tceoo1/TubeTester/doc/真空管特性計測基板.pdf

# 真空管特性計測基板 TubeTester

# これは何？

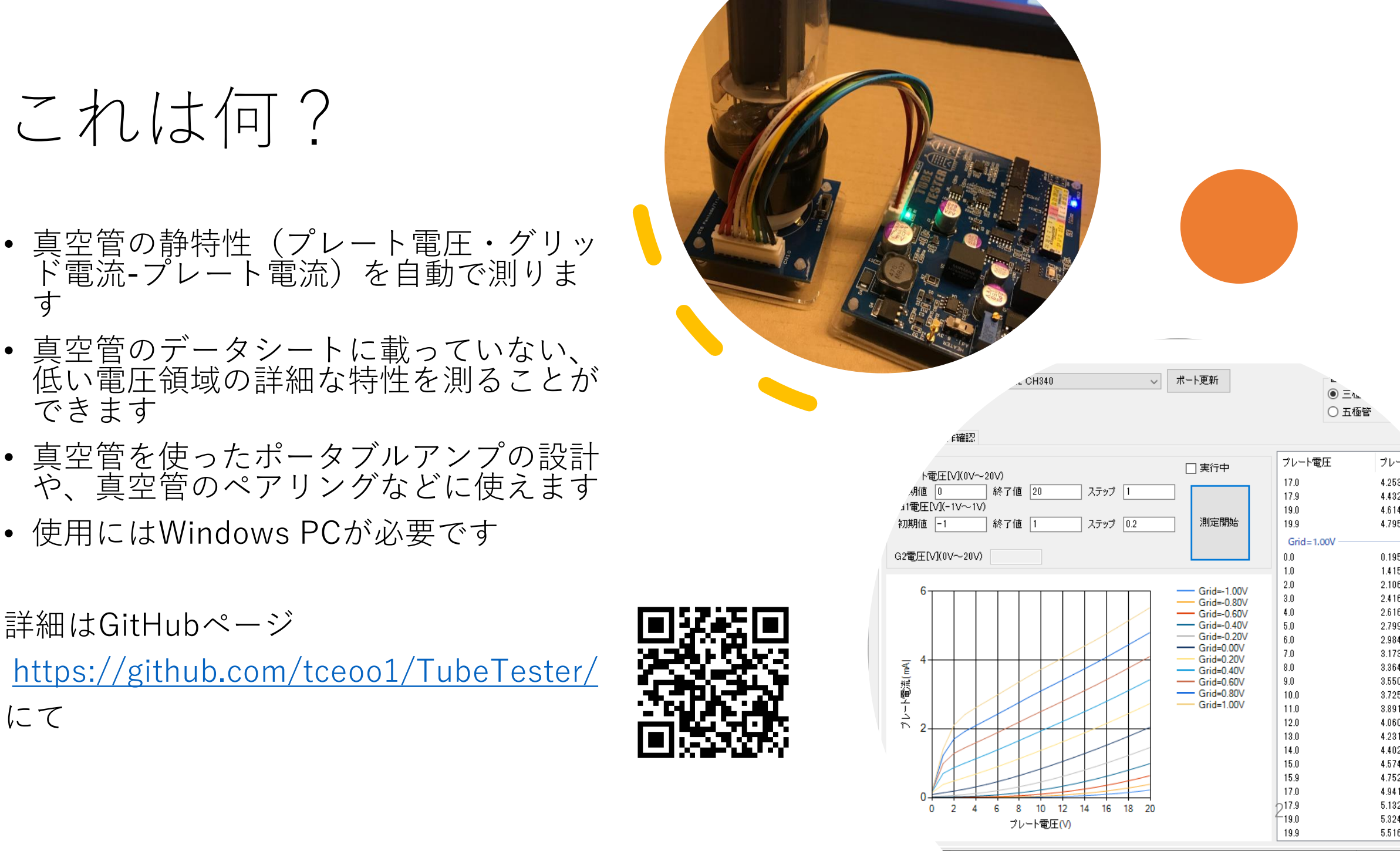
[picture p3: page 2]

- 真空管の静特性（プレート電圧・グリッ
ド電流

-プレート電流）を自動で測りま
す
- 真空管のデータシートに載っていない、
低い電圧領域の詳細な特性を測ることが
できます
- 真空管を使ったポータブルアンプの設計
や、真空管のペアリングなどに使えます
- 使用にはWindows PCが必要です

詳細はGitHubページ
https://github.com/tceoo1/TubeTester/にて

# 各部の説明

電圧チェック
端子（＋）

電圧チェック
端子（ー）

電圧調整VR

ヒータ電圧切
り替えSW

真空管電源

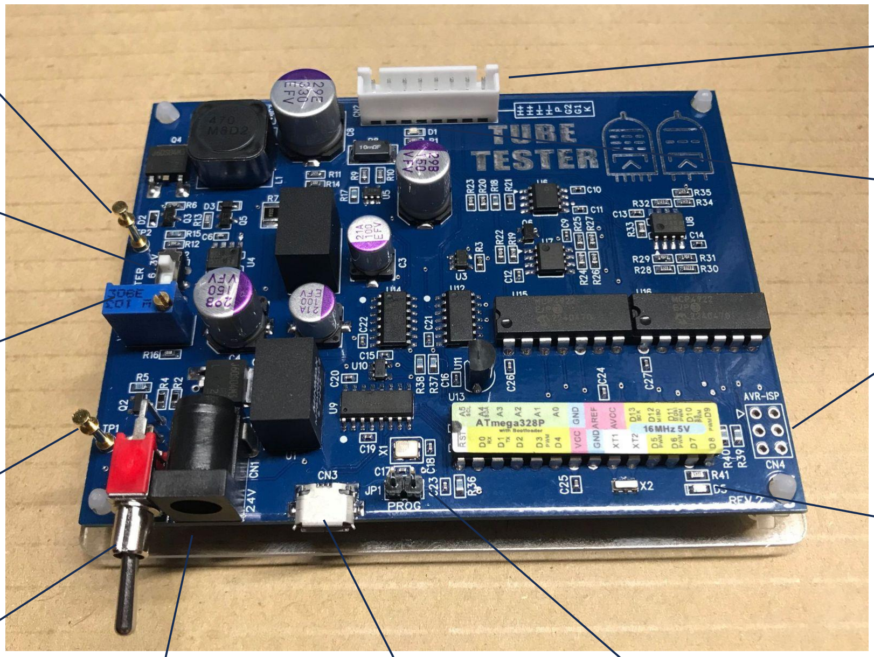
[picture p4: figure]

SW | 真空管電源
| (２４V)

PC接続
USB端子

真空管接続
端子

AVR ISP端子
（未実装）

スケッチ書き込
み用ジャンパ

真空管電源
LED（緑）

AVR動作
LED（青）

# 各部の説明

名称 | 説明
電圧チェック端子 | ヒータ電圧のチェック端子です。ヒータ電源調整時に使います
ヒータ電源切り替えSW | ヒータ電源を6.3VにするかVR調整にするか切り替えます
電圧調整VR | ヒータ電源調整用ボリューム
真空管電源SW | 真空管側の電源SW。真空管着脱時はOFFにします。
真空管電源端子(24V) | 真空管側の電源。DC24Vを供給します。
PC接続用USB端子 | PC接続用USB端子。シリアルポートとして認識されます。
スケッチ書き込み用ジャンパ | ジャンパを接続するとスケッチを書き込みできるようになります。
真空管接続端子 | 真空管と接続する端子。XH 8Pハーネスでアダプタと接続します。
真空管電源LED | 真空管の電源が供給されていると点灯します。
AVR ISP端子 | Arduinoブートローダを書き込む時使います。
AVR動作LED | AVRマイコンの動作状態を表します。正常動作時点灯します。

# PC用計測ソフト【カーブ計測タブ】

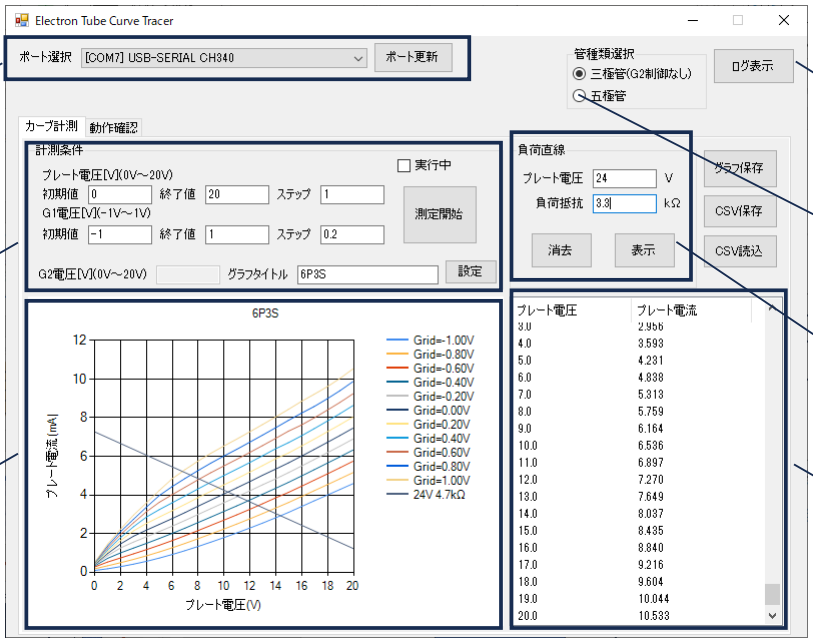
[picture p5: figure]

計測結果
（グラフ）

計測条件
設定

シリアル
ポート設定

計測結果
（計測値）

管種類選択

通信ログ
表示

負荷直線
表示

# PC用計測ソフト【動作確認タブ】

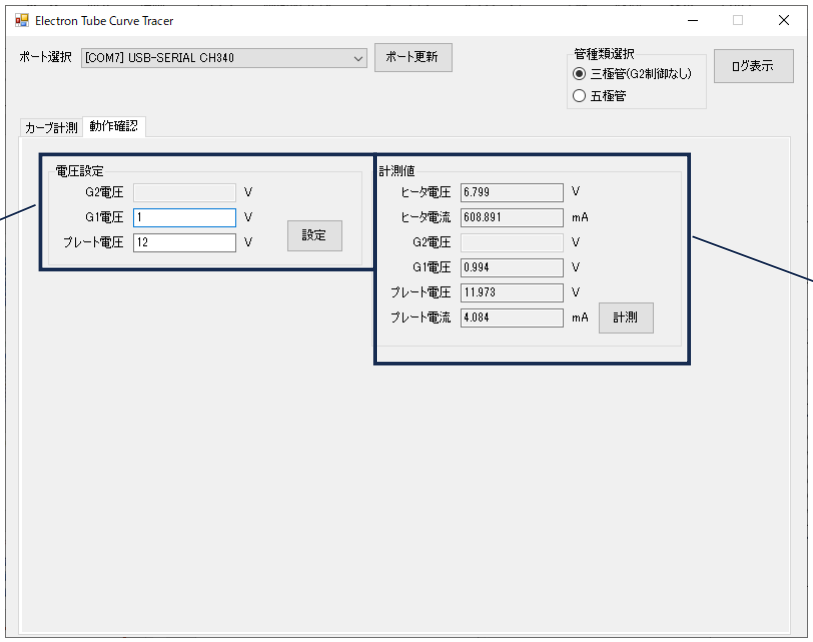
[picture p6: figure]

電圧設定
計測値取得

# つかいかた

# ①機器を接続します

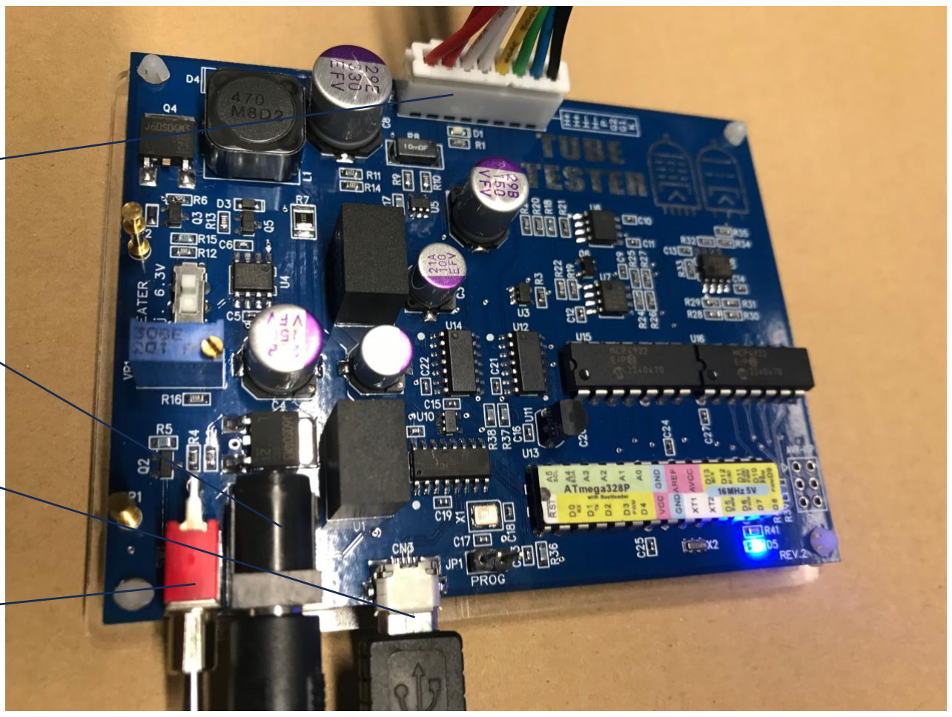
[picture p7: figure]

真空管アダプタへ

ACアダプタ(24V)

PC(USB)

スイッチはOFF

# ②アダプタに真空管を取り付けます

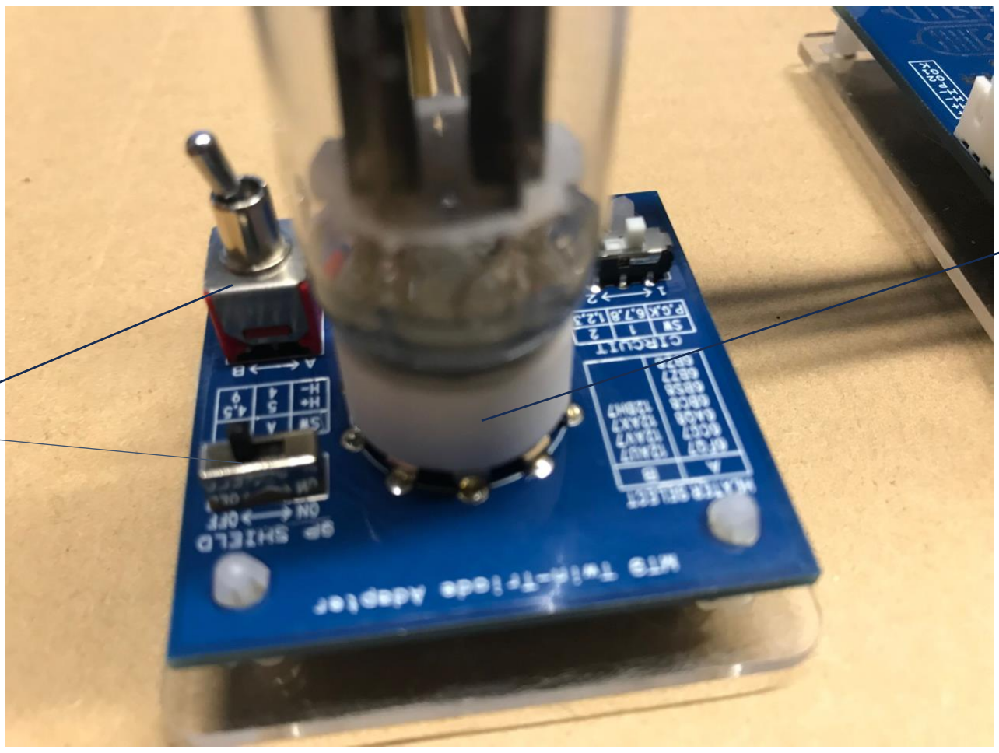
[picture p8: figure]

ソケットに
差し込む

必要に応じ、ス
イッチ類の設定

# ③PCで計測ツールを起動します

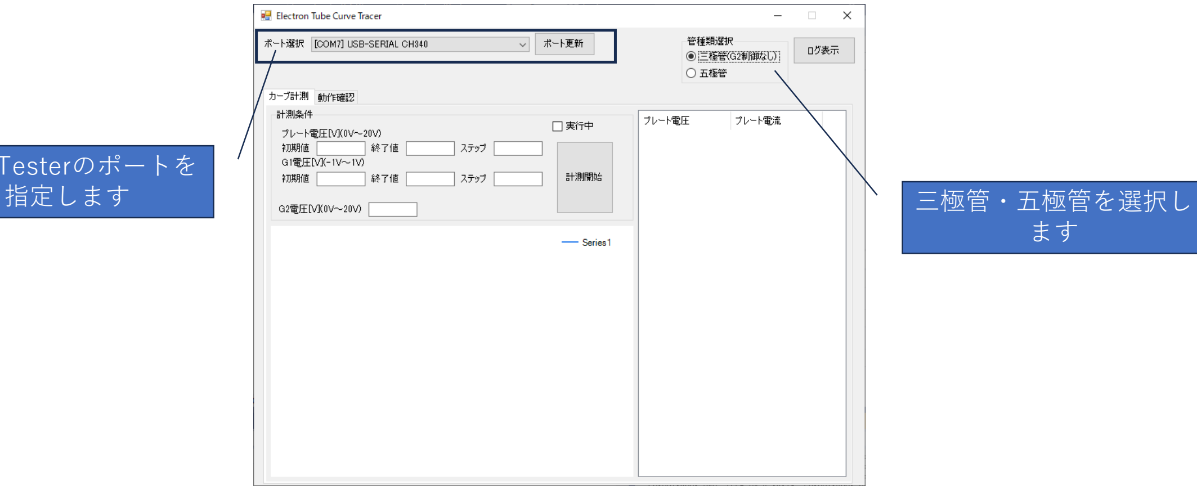
[picture p9: figure]
指定します; 三極管・五極管を選択し

TubeTesterのポートを

# ④真空管に通電し、計測をします

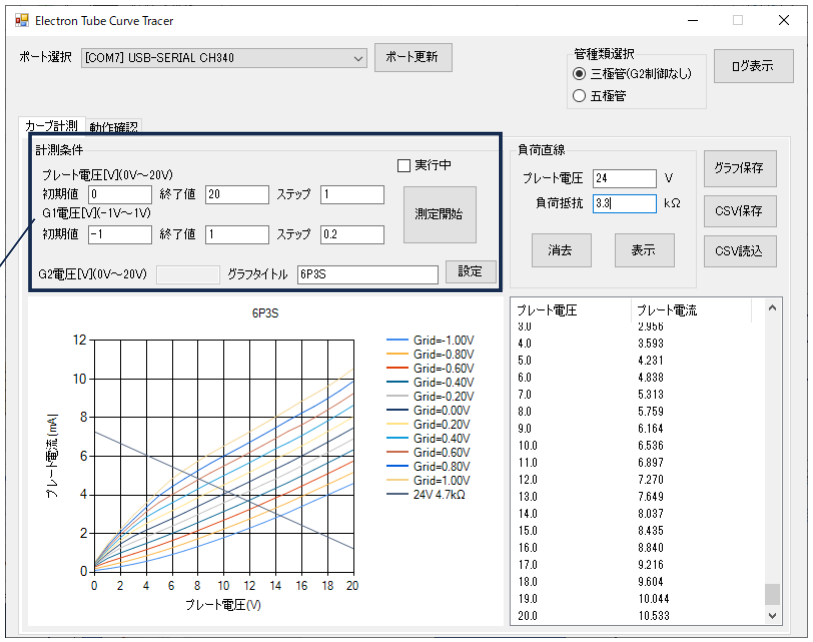
[picture p10: figure]

計測条件を設定し、
「測定開始」ボタン
をClick

# グラフの保存（画像）

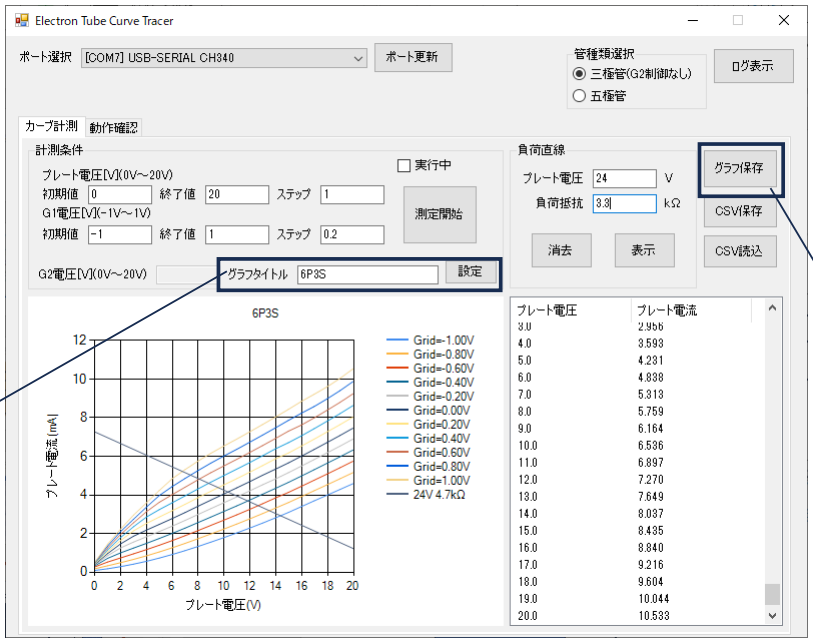
[picture p11: figure]

必要に応じ、グラフタ
イトルを入力し「設
定」ボタンをClick

「グラフ保存」ボタ
ンをClick

保存形式は、
JPG,PNG,BMP,EMF

# CSV保存

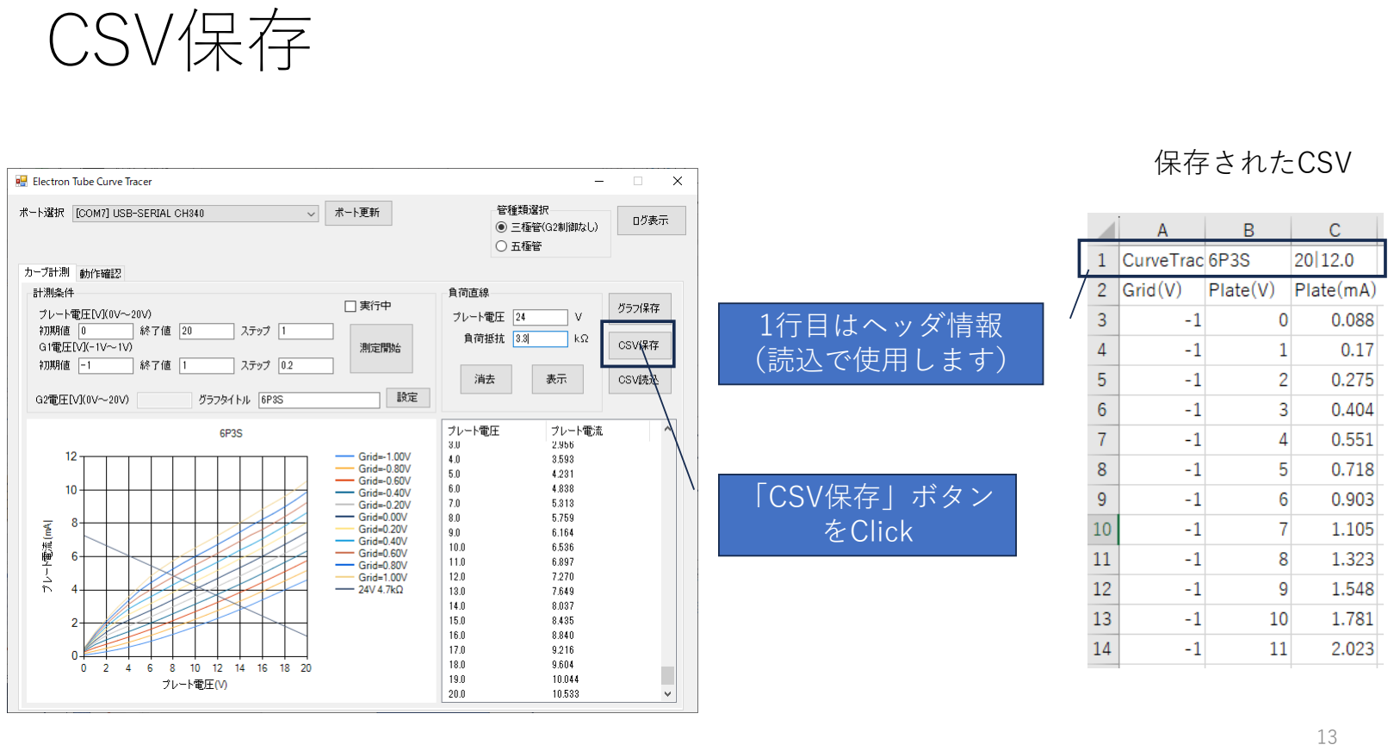
[picture p12: page 13]

「CSV保存」ボタン
をClick

保存されたCSV

1行目はヘッダ情報
（読込で使用します）

# CSV読込

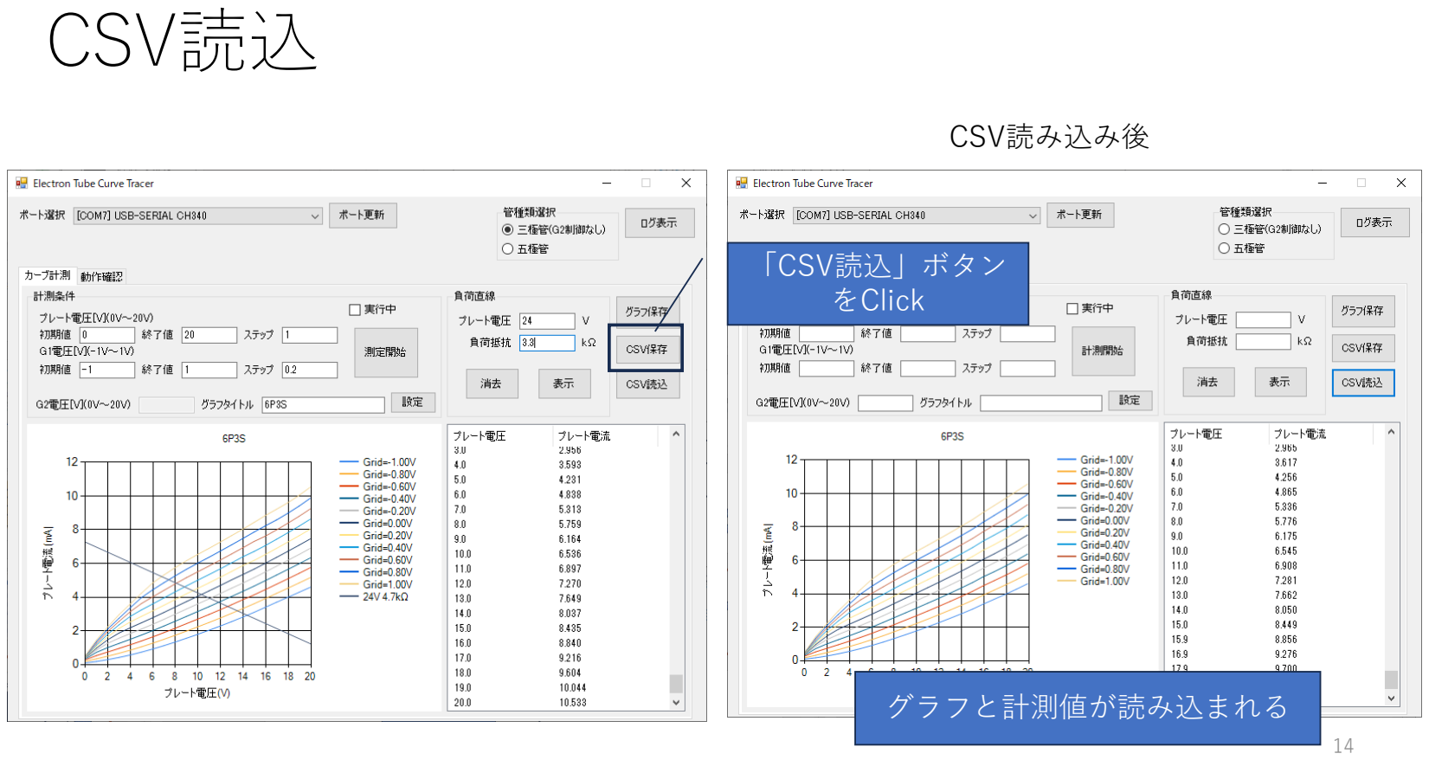
[picture p13: page 14]

「CSV読込」ボタン
をClick

CSV読み込み後

グラフと計測値が読み込まれる

# Enjoy your tube life!
