tceoo1/TubeTester/doc/TubeAdapters.pdf

MT9 双三極管アダプタ
項目 | メーカ | 品番 | URL
シールド接地SW | XIAMEN | SS-12D00G3 | https://akizukidenshi.com/catalog/g/g115707/
回路切り替えSW | Switronic | IS-2235-G | https://akizukidenshi.com/catalog/g/g102627/
ヒータ結線切り替えSW | Cosland | 2MD1-T2-B4-M2-Q-N | https://akizukidenshi.com/catalog/g/g100301/
真空管ソケット | N/A | GZC9-A-G | https://www.aitendo.com/product/13975
コネクタ | JST | B8B-XH-A(LF)(SN) | https://akizukidenshi.com/catalog/g/g112253/

MT7 五極管アダプタ
項目 | メーカ | 品番 | URL
結線切り替えSW | ECE | EDS104SZ | https://akizukidenshi.com/catalog/g/g100586/
三結切り替え（P-G2短絡）SW | XIAMEN | SS-12D00G3 | https://akizukidenshi.com/catalog/g/g115707/
真空管ソケット | N/A | GZC7-Y-B-G | https://www.aitendo.com/product/21797
コネクタ | JST | B8B-XH-A(LF)(SN) | https://akizukidenshi.com/catalog/g/g112253/

GT8 五極管アダプタ
項目 | メーカ | 品番 | URL
三結切り替え（P-G2短絡）SW | XIAMEN | SS-12D00G3 | https://akizukidenshi.com/catalog/g/g115707/
真空管ソケット | N/A | GZC8-Y-2 | https://www.aitendo.com/product/14621
コネクタ | JST | B8B-XH-A(LF)(SN) | https://akizukidenshi.com/catalog/g/g112253/

GT8 双三極管アダプタ
項目 | メーカ | 品番 | URL
回路切り替えSW | Switronic | IS-2235-G | https://akizukidenshi.com/catalog/g/g102627/
コネクタ | JST | B8B-XH-A(LF)(SN) | https://akizukidenshi.com/catalog/g/g112253/
