tceoo1/TubeTester/.media/img_1.png

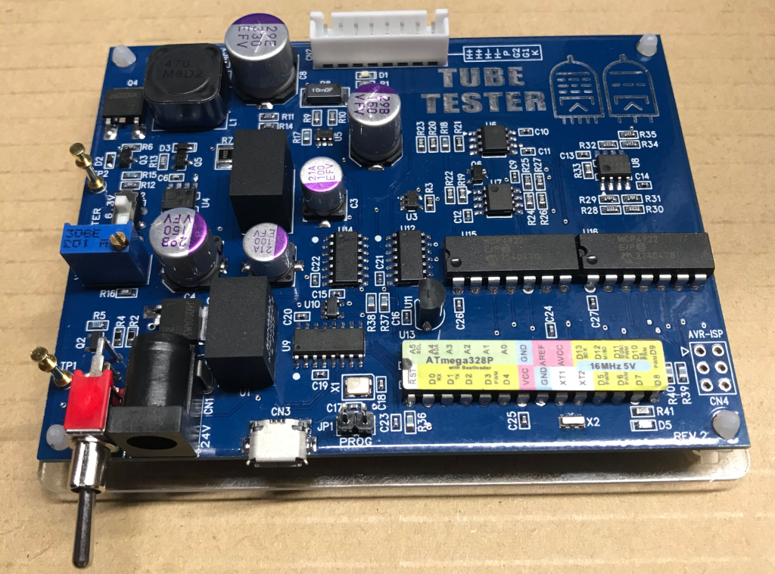
.media/img_1.png
