tceoo1/TubeTester/(commit log)

2023-08-08 初回コミット
2023-08-08 LICENSEファイル追加
2023-08-08 Readme.mdのリンク先修正
2023-08-10 初回release
2023-08-19 ヒータ電圧の計算式の誤り修正
2024-01-06 MG7Pアダプタシルク誤りについて追記
2024-01-14 グラフ保存及びCSV保存・読み込み機能の追加
2025-09-24 ドキュメントを追加
